turatig/NSS/PresentazionePROS.pdf

# Night Surveillance System: termocamera di

sorveglianza notturna basata su STM32F407.

# Progettazione di Sistemi Operativi

Università degli Studi di Milano.

# July 12, 2022

Giacomo Turati (Università degli Studi di Milano) | Night Surveillance System | July 12, 2022 | 1 / 29

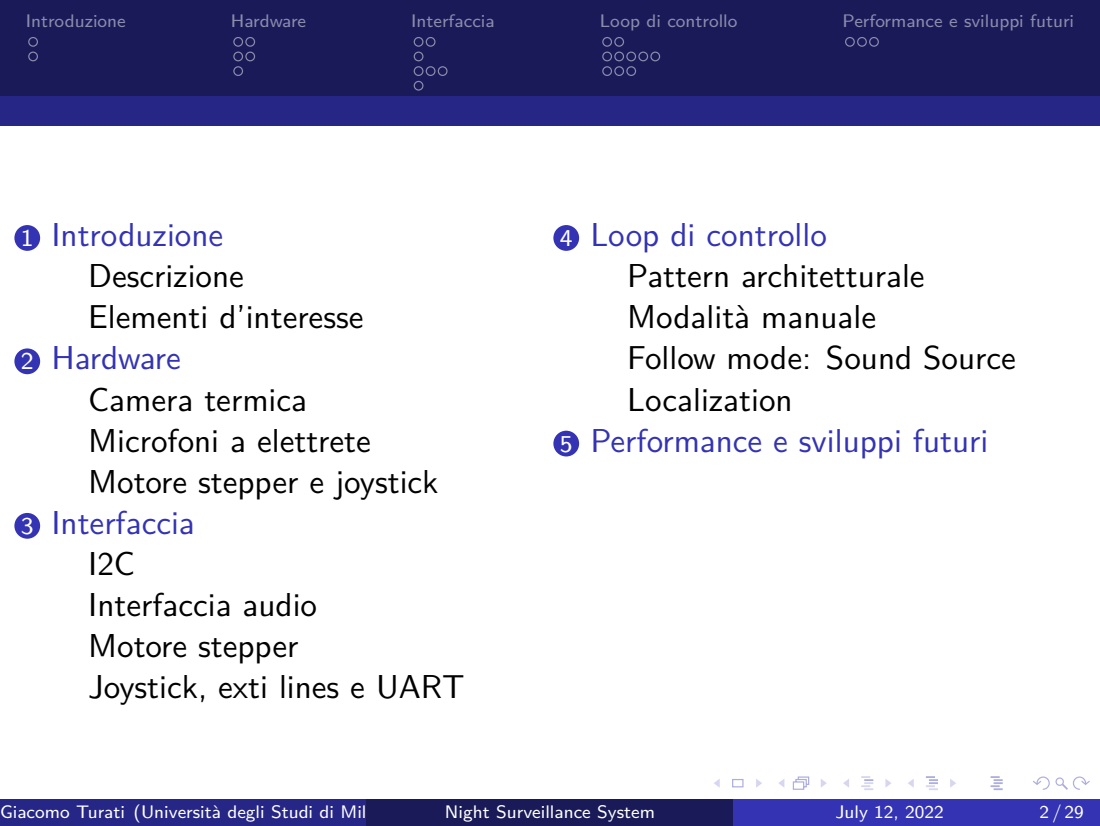
[picture p1: page 2]
Giacomo Turati (Università degli Studi di Milano); Night Surveillance System; July 12, 2022

1 Introduzione
Descrizione
Elementi d’interesse
2 Hardware
Camera termica
Microfoni a elettrete
Motore stepper e joystick
3 Interfaccia
Interfaccia audio
Motore stepper
Joystick, exti lines e UART

4 Loop di controllo
Pattern architetturale
Modalità manuale
Follow mode: Sound Source
Localization
5 Performance e sviluppi futuri

# Il dispositivo si propone come prototipo di camera di sorveglianza notturna con le seguenti modalità di funzionamento:

1 Manuale: consente acquisizione e streaming immagine termica,

# acquisizione e playback audio ambientale in stereo e orientamento

manuale della camera tramite joystick.

# 2 Follow: il dispositivo reagisce a stimoli sonori sopra soglia cercando di

localizzare una sorgente sonora nello spazio circostante.

# Componenti: 1 Camera termica: AMG8833 2 Microfoni a elettrete 3 Motore stepper unipolare 28BYJ-48 4 Joystick analogico 5 Bottoni di controllo 6 STM32F407-discovery1

Giacomo Turati (Università degli Studi di Milano) | Night Surveillance System | July 12, 2022 | 3 / 29

# L’obiettivo del progetto è quello di realizzare un sistema di sorveglianza che monitori diversi tipi di dato ambientali e che possa reagire attivamente

a cambi di circostanze nel perimetro da monitorare.

# Elementi d’interesse a livello di progettazione software: 1 Gestione simultanea di streaming real-time multipli e controllo

attuatori.

# 2 Interazione a basso livello con le componenti hardware e sviluppo di

driver dedicati.

# 3 Scrittura di ISR, utilizzo DMA e periferiche senza mediazione di un

RTOS.

Giacomo Turati (Università degli Studi di Milano) | Night Surveillance System | July 12, 2022 | 4 / 29

# Camera termica

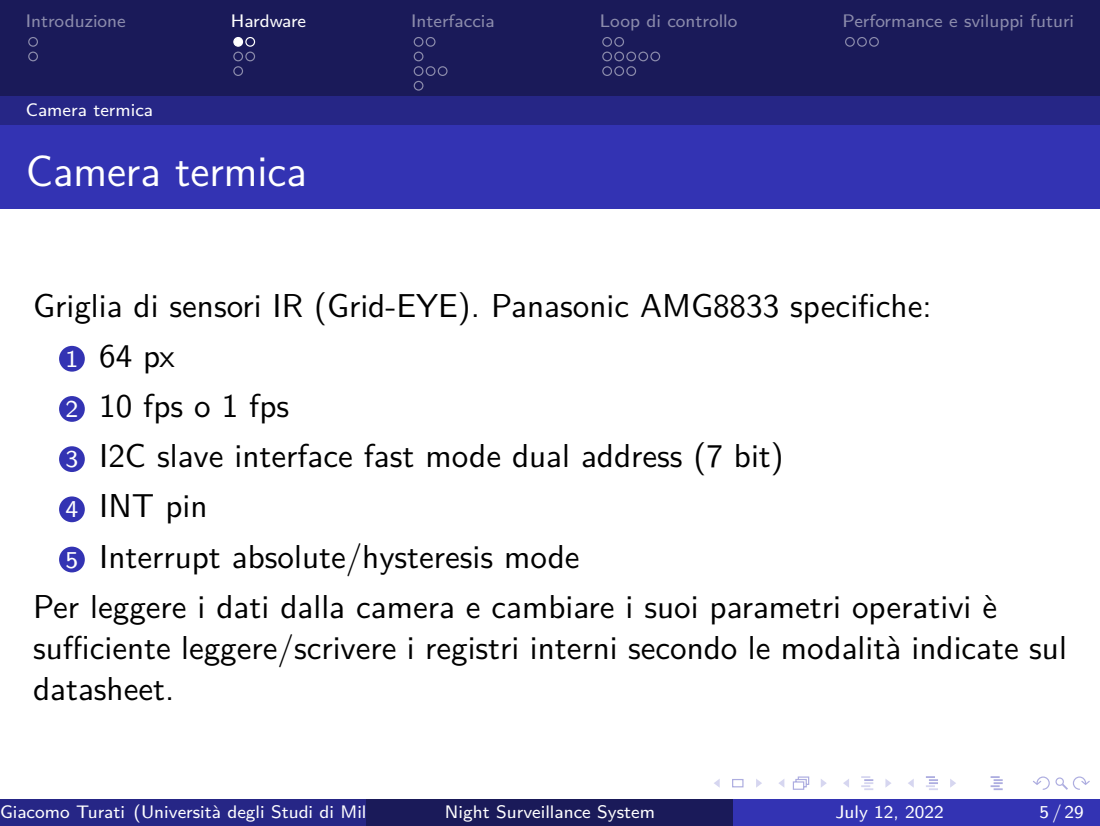
[picture p2: page 5]
Camera termica; Giacomo Turati (Università degli Studi di Milano); Night Surveillance System; July 12, 2022

Griglia di sensori IR (Grid-EYE). Panasonic AMG8833 specifiche:
2 10 fps o 1 fps
3 I2C slave interface fast mode dual address (7 bit)
4 INT pin
5 Interrupt absolute/hysteresis mode
Per leggere i dati dalla camera e cambiare i suoi parametri operativi è
sufficiente leggere/scrivere i registri interni secondo le modalità indicate sul
datasheet.

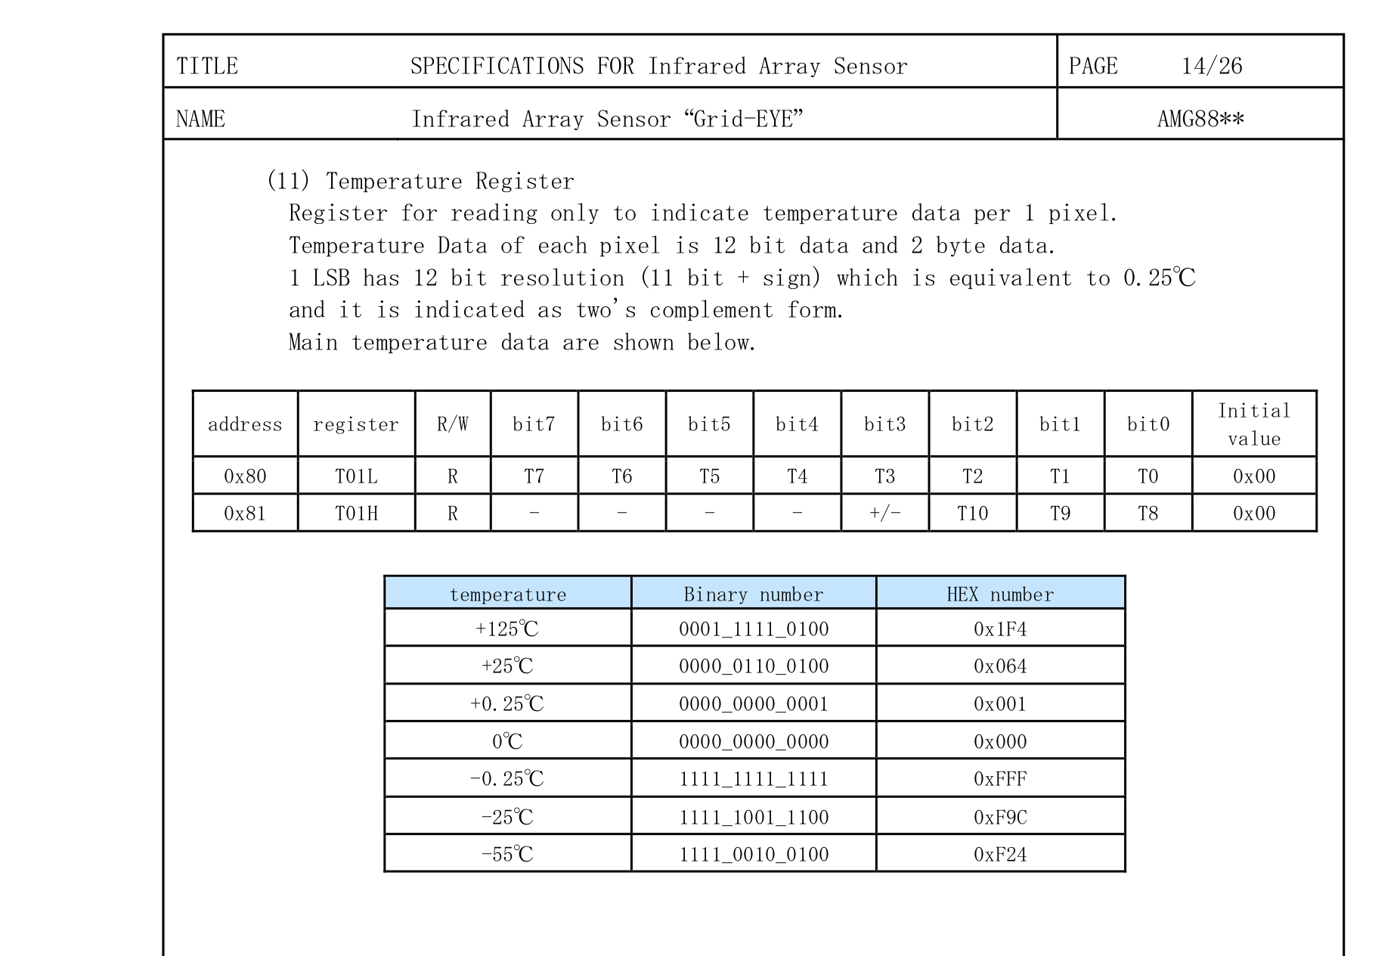
[picture p3: figure]

## Figure 1: Specifiche registri di temperatura datasheet Grid-EYE AMG8833

Giacomo Turati (Università degli Studi di Milano) | Night Surveillance System | July 12, 2022 | 6 / 29

# Microfoni a condensatore basati su membrana di elettrete con carica elettrostatica permanente (no polarizzazione esterna). Alimentazione

necessaria per transistor FET di adattamento in impedenza.

# Specifiche:

1 Range di risposta in frequenza: 20-20kHz.
2 Ampiezza picco-picco 200mV (±100mV) in saturazione.

# Preamplificazione: condizionamento necessario per portare il segnale nel range ADC [0V-3V]. Rail-to-rail opamp (TLE2022) in configurazione

invertente con partitore su terminale positivo.

Giacomo Turati (Università degli Studi di Milano) | Night Surveillance System | July 12, 2022 | 7 / 29

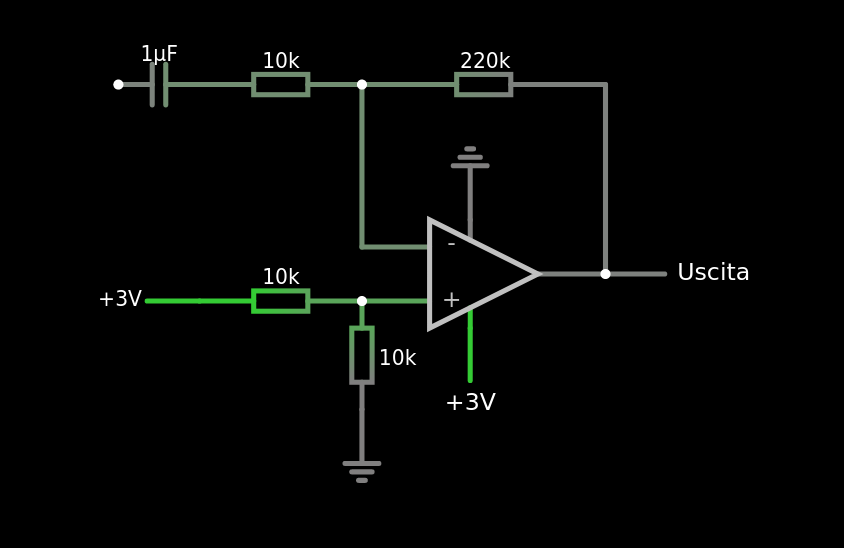
[picture p4: figure]

## Figure 2: Schema circuitale preamplificatore microfonico

Giacomo Turati (Università degli Studi di Milano) | Night Surveillance System | July 12, 2022 | 8 / 29

# Motore stepper e joystick

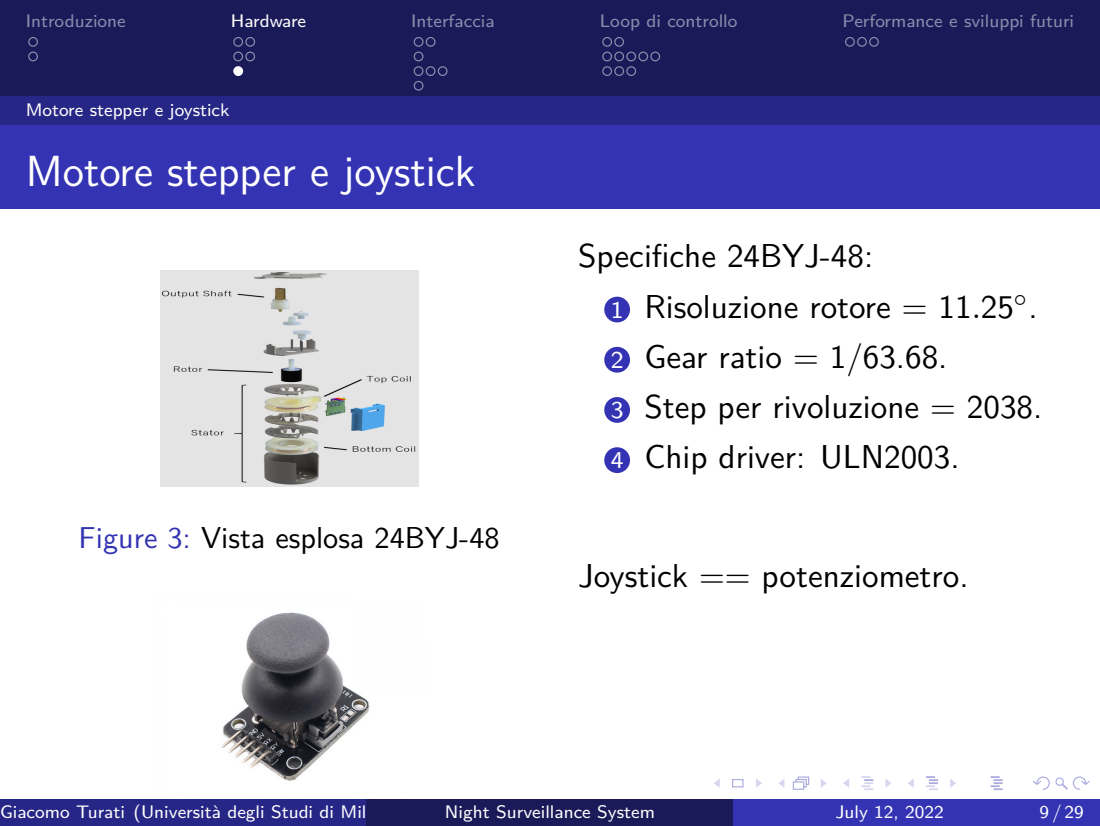
[picture p5: page 9]
Joystick == potenziometro.; Giacomo Turati (Università degli Studi di Milano); Night Surveillance System; July 12, 2022

Motore stepper e joystick

Specifiche 24BYJ-48:
1 Risoluzione rotore = 11.25◦
2 Gear ratio = 1/63.68.
3 Step per rivoluzione = 2038.
4 Chip driver: ULN2003.

Figure 3: Vista esplosa 24BYJ-48

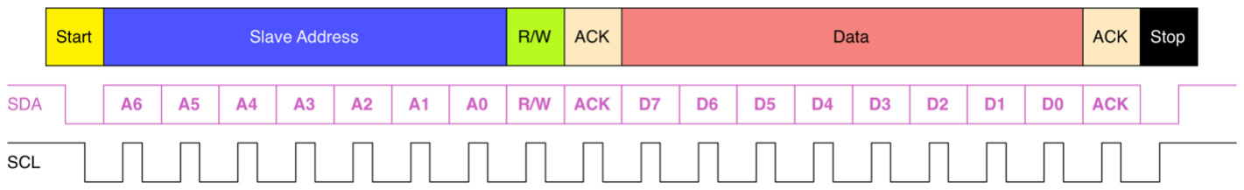
[picture p6: figure]

## Figure 4: Protocollo di comunicazione seriale I2C

# Master inizia le transazioni di lettura/scrittura tramite START condition (HIGH to LOW). Specifica indirizzo dello slave in address frame. Il primo data frame specifica l’indirizzo del registro da cui leggere/in cui scrivere e gli altri sono di dati. Lettura/scrittura con ACK fino a STOP condition

(da LOW ad HIGH).

# Sensore AMG8833 configurato per rispondere a indirizzo a 7 bit 0x68. PB6

e PB7 con resistenze di pull-up esterne per line SCL e SDA a 400kbps.

Giacomo Turati (Università degli Studi di Milano) | Night Surveillance System | July 12, 2022 | 10 / 29

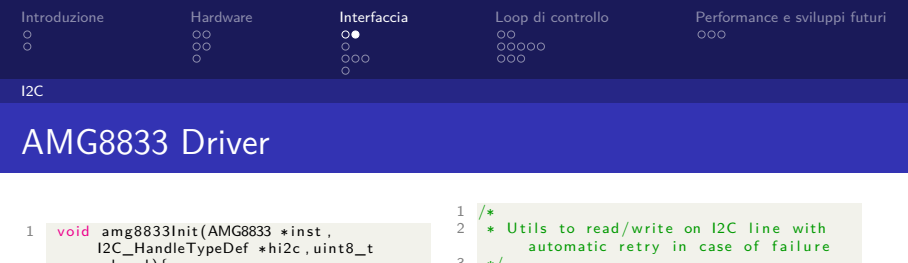
[picture p7: figure]
I2C AMG8833 Driver; I2C_HandleTypeDef ∗hi2c , uint8_t

1 | void amg8833Init (AMG8833 ∗ inst ,
| ad_sel ){
2 | inst −>adri2c= ad_sel ? (
| AMG8833_I2C_BASE_ADR + 1 ) << 1 :
| AMG8833_I2C_BASE_ADR << 1;
3 | inst −>hi2c=hi2c ;
4 | }
1 | /∗
2 | ∗ Read temperature matrix in DMA mode
3 | ∗/
4 | HAL_StatusTypeDef amg8833ReadDMA(AMG8833 ∗
| inst , uint8_t ∗data , uint8_t max_retry
| ){
5
6 | return I2C_ReadDMA( inst ,AMG8833_T01L,
| data ,AMG8833_DS, max_retry ) ;
7 | }
8

2 ∗ U t i l s to read/ write on I2C l i n e with automatic r e t r y in case of f a i l u r e
3 | ∗/
4 | HAL_StatusTypeDef I2C_Read(AMG8833 ∗ inst ,
uint8_t reg , uint8_t ∗data , uint16_t dim , uint8_t max_retry ){
5
6 | uint8_t t r y =0;
7 | HAL_StatusTypeDef status ;
8
9 | do{
10 | t r y++;
| 11 | status=HAL_I2C_Mem_Read_DMA( inst
−>hi2c , ( uint16_t ) inst −>adri2c , reg ,1 ,
| data , dim) ;
12 | } while ( status !=HAL_OK && t r y <=
| max_retry ) ;
| 13
14 | return status ;
| 15
16 | }
| 17
Inoltre scritte funzioni di libreria per la gestione della interrupt mode.
Giacomo Turati (Università degli Studi di Milano) | Night Surveillance System | July 12, 2022 | 11 / 29

# Interfaccia audio

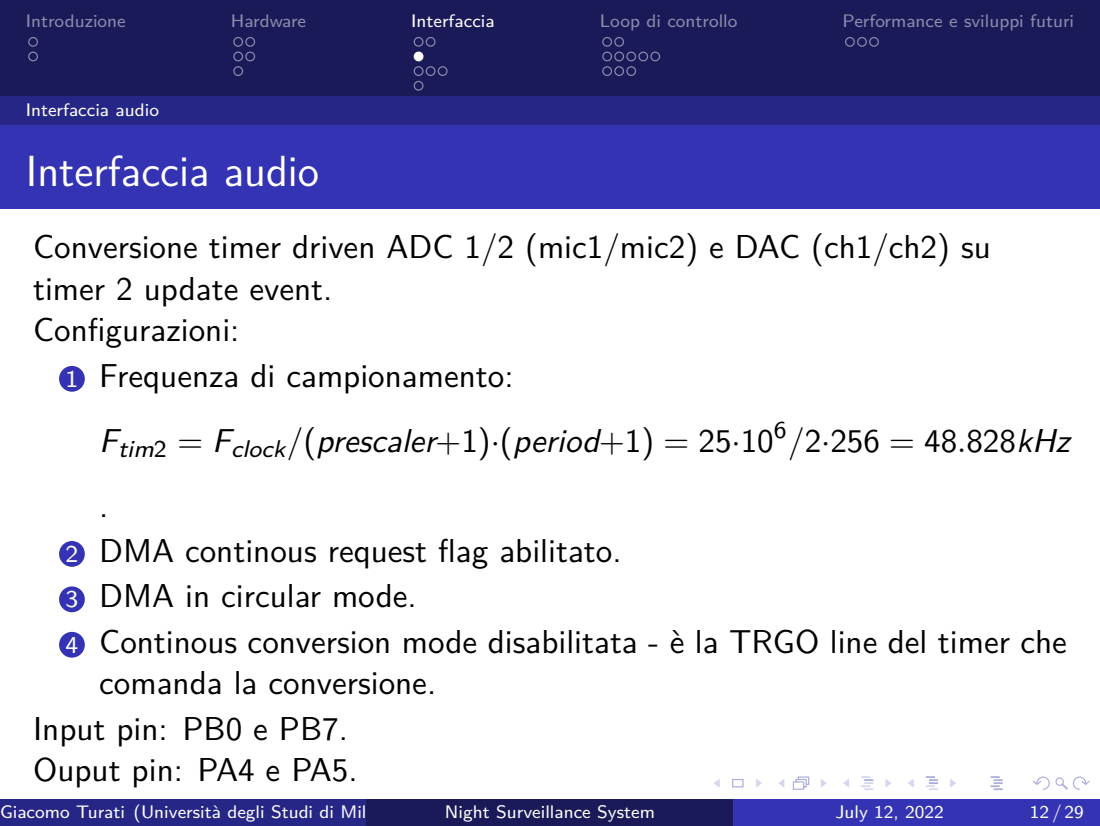
[picture p8: page 12]
Interfaccia audio; /2·256 = 48.828kHz; Giacomo Turati (Università degli Studi di Milano); Night Surveillance System; July 12, 2022

Conversione timer driven ADC 1/2 (mic1/mic2) e DAC (ch1/ch2) su
timer 2 update event.
Configurazioni:
1 Frequenza di campionamento:
Ftim2 = Fclock/(prescaler+1)·(period+1) = 25·10⁶

2 DMA continous request flag abilitato.
3 DMA in circular mode.
4 Continous conversion mode disabilitata - è la TRGO line del timer che
comanda la conversione.
Input pin: PB0 e PB7.
Ouput pin: PA4 e PA5.

# Motore stepper

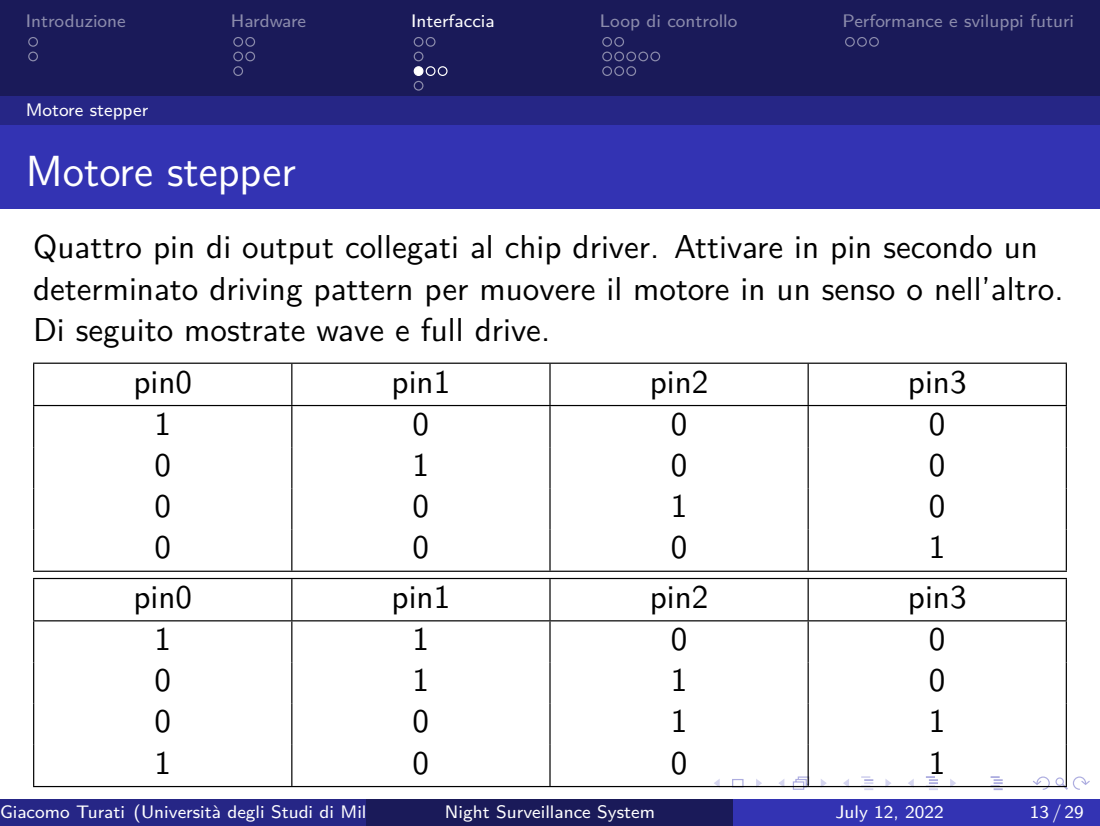
[picture p9: page 13]
Motore stepper; Giacomo Turati (Università degli Studi di Milano); Night Surveillance System; July 12, 2022

Quattro pin di output collegati al chip driver. Attivare in pin secondo un
determinato driving pattern per muovere il motore in un senso o nell’altro.
Di seguito mostrate wave e full drive.

pin0 | pin1 | pin2 | pin3
1 0 0 0 | 0 1 0 0 | 0 0 1 0 | 0 0 0 1

1 0 0 1 | 1 1 0 0 | 0 1 1 0 | 0 0 1 1

# Driver motore

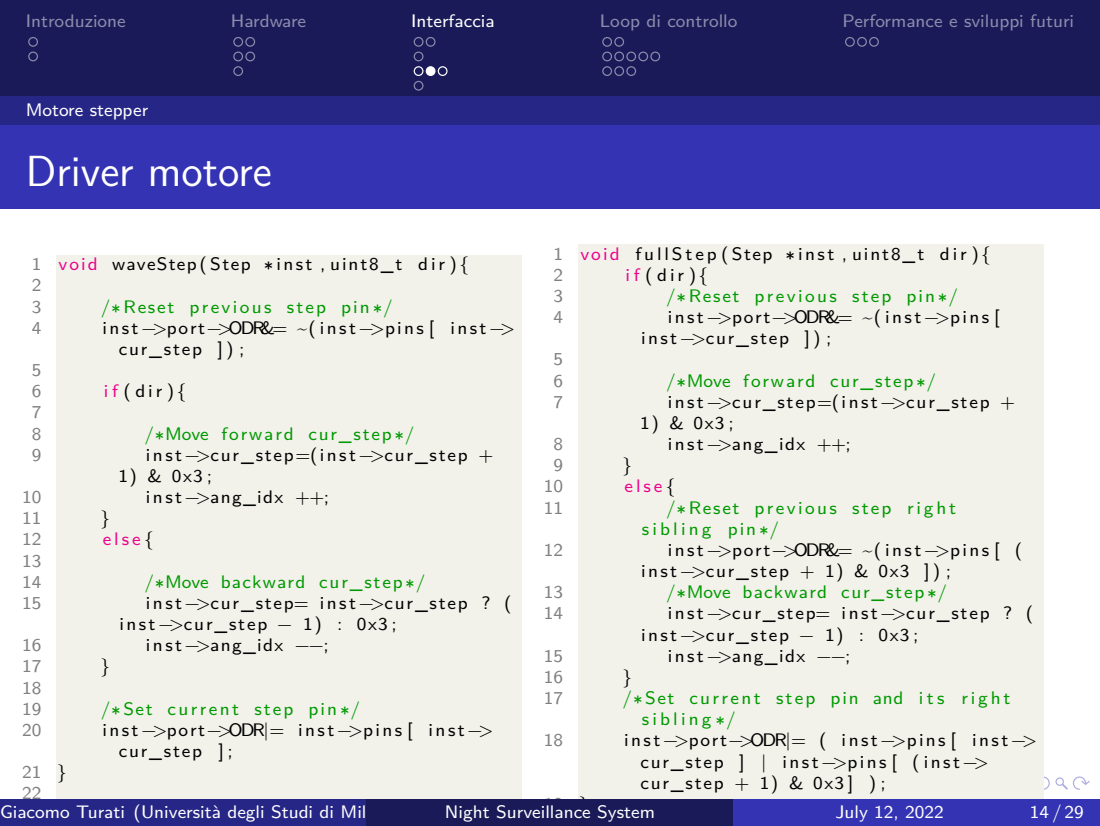
[picture p10: page 14]
Motore stepper; void waveStep ( Step ∗ inst , uint8_t d i r ){; /∗Reset previous step pin ∗/; inst −>port−>ODR&= ~( inst −>pins [ inst −>; cur_step ] ) ;; /∗Move forward cur_step ∗/; inst −>cur_step=(inst −>cur_step +; inst −>ang_idx ++;; /∗Move backward cur_step ∗/; inst −>cur_step= inst −>cur_step ? (; inst −>cur_step − 1) : 0x3 ;; inst −>ang_idx −−;; /∗Set current step pin ∗/; inst −>port−>ODR|= inst −>pins [ inst −>; cur_step ] ;; void f u l l S t e p ( Step ∗ inst , uint8_t d i r ){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

cur_step ] | inst −>pins [ ( inst −>
cur_step + 1) & 0x3 ] ) ;

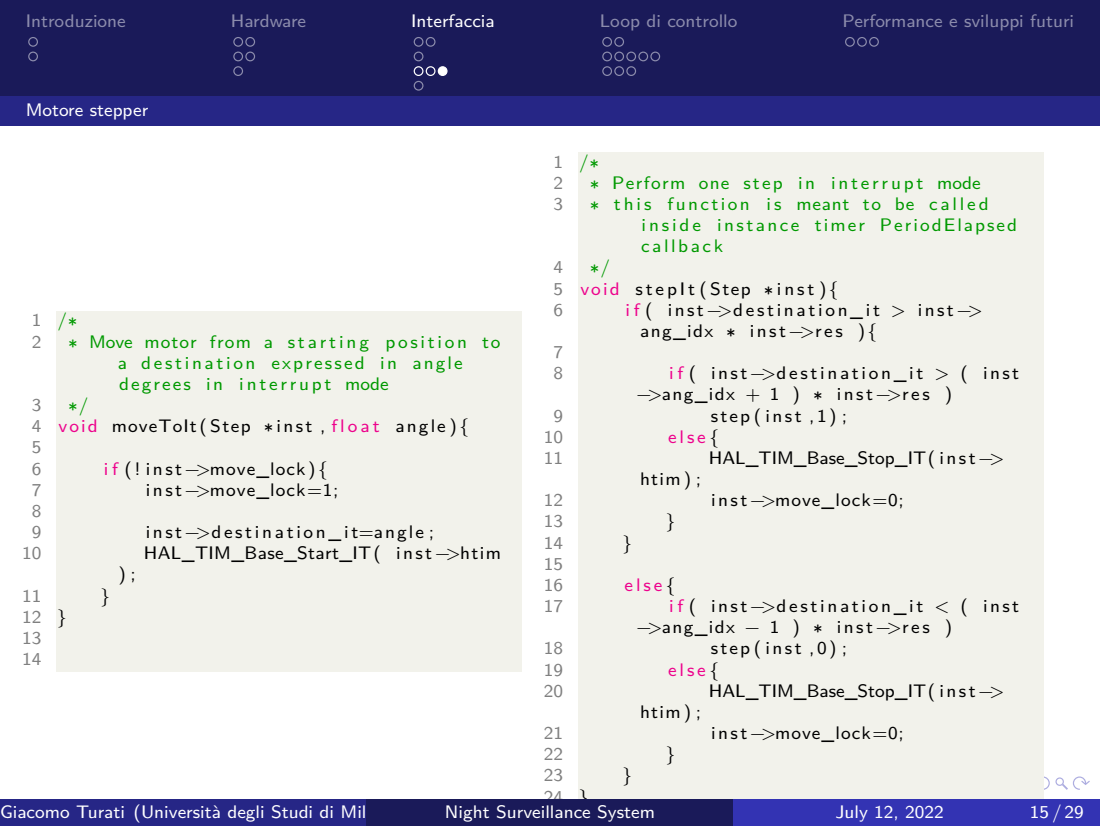
[picture p11: page 15]
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

i n s i d e instance timer PeriodElapsed

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

Giacomo Turati (Università degli Studi di Milano) | Night Surveillance System 25 | 15 / 29

July 12, 2022

# 1 Joystick: alimentato a 3V, conversione in polling mode del valore di

tensione in ingresso all’ADC3. Single channel/conversion mode. Lettura mono-asse, bidirezionale (destra/sinistra).
2 Bottoni di controllo: switch modalità, controllo motore singolo step. Input pin con internal pull-up, external interrupt falling edge mode.

# La pressione di un tasto attiva un timer di debounce allo scadere del

quale lo stato dei pin d’ingresso viene ricontrollato.

# 3 AMG8833 INT pin: external interrupt falling edge mode, resistenza di

pull-up esterna (ingresso open drain).
4 UART3 per output immagine termica e UART6 per print di debug.
Giacomo Turati (Università degli Studi di Milano) | Night Surveillance System | July 12, 2022 | 16 / 29

# Difficoltà principale del progetto: controllo simultaneo di diverse periferiche rispettando le deadline imposte dalla conversione audio, dal frame rate di acquisizione dell’immagine termica e dal movimento fluido

del motore. Impossibile gestire tutte le periferiche in polling sequenziale.

# Obiettivi: architettura uniforme e comprensibile. Codice ISR efficiente e

non-error-prone.

# Soluzione: set/reset di status flag in bit band region nelle ISR e polling

occasionale su questi ultimi nel loop di controllo.

Giacomo Turati (Università degli Studi di Milano) | Night Surveillance System | July 12, 2022 | 17 / 29

# Modalità

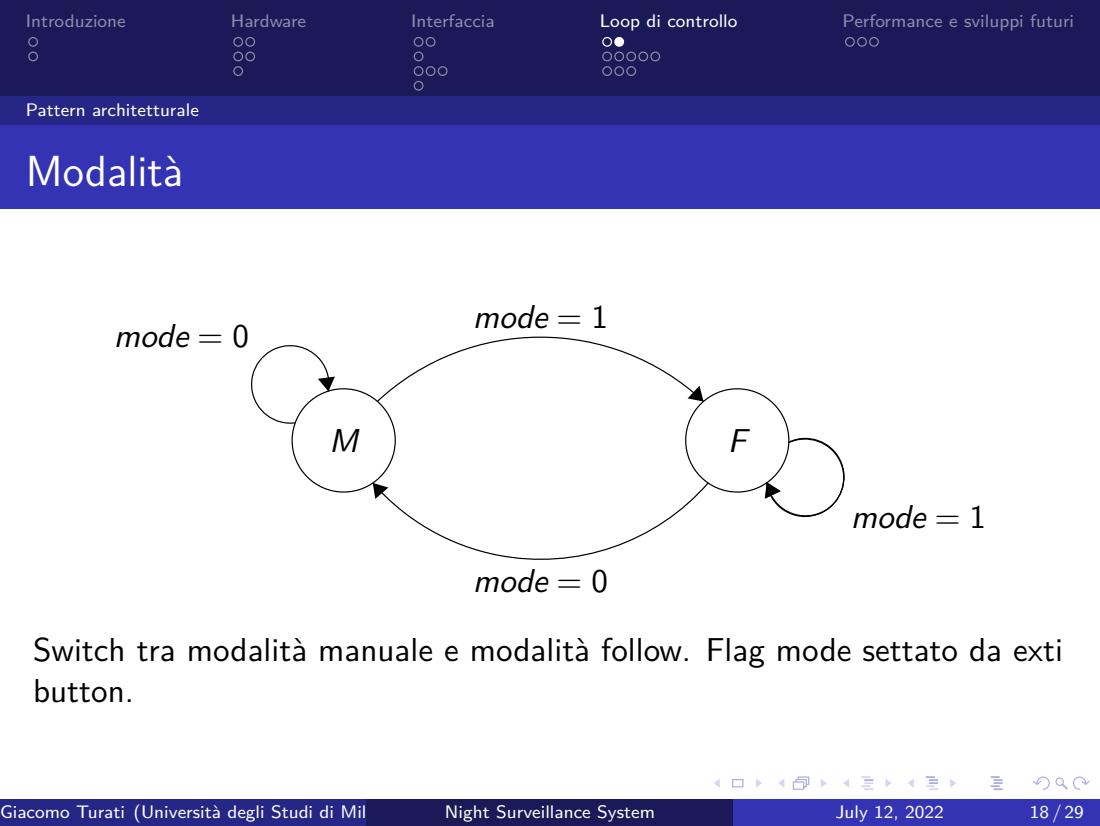
[picture p12: page 18]
Pattern architetturale; mode = 0; mode = 1; Giacomo Turati (Università degli Studi di Milano); Night Surveillance System; July 12, 2022

Switch tra modalità manuale e modalità follow. Flag mode settato da exti
button.

# Thermal image FSM

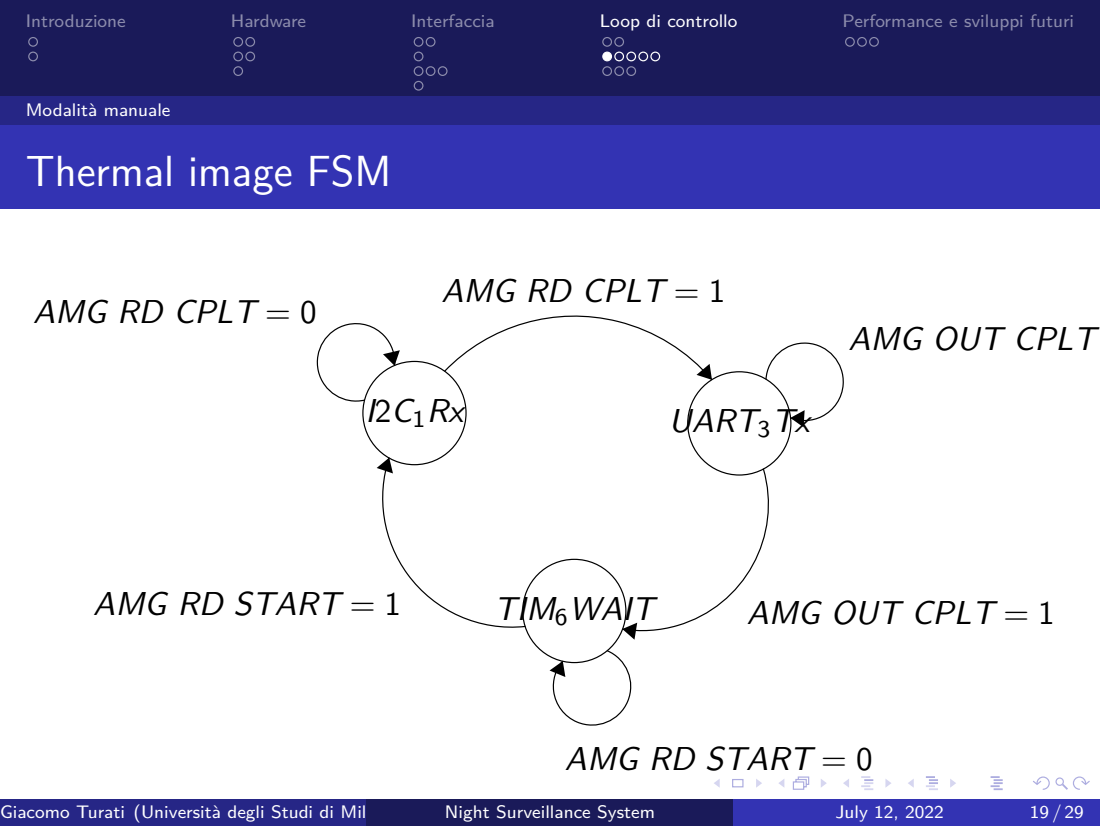
[picture p13: page 19]
Modalità manuale; UART3Tx; TIM6WAIT; Giacomo Turati (Università degli Studi di Milano); Night Surveillance System; July 12, 2022

AMG RD CPLT = 1

AMG RD CPLT = 0

AMG OUT CPLT = 0

AMG RD START = 1

AMG OUT CPLT = 1

AMG RD START = 0

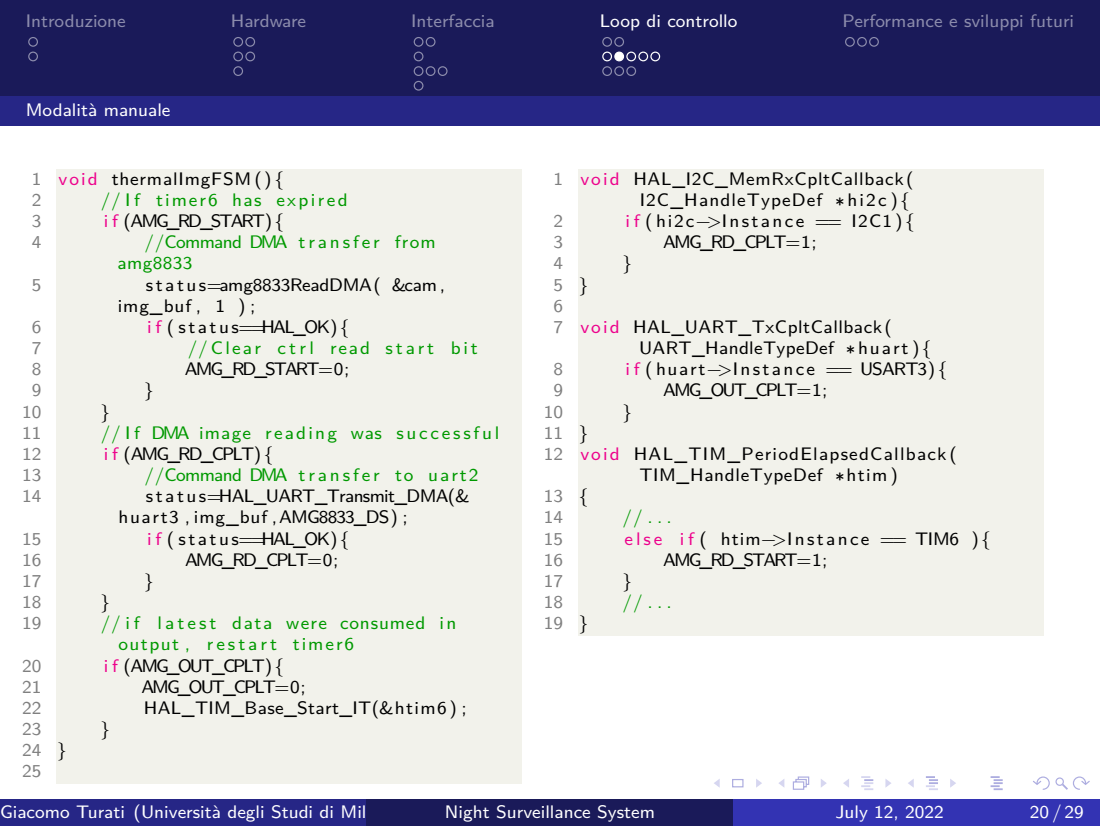
[picture p14: page 20]
Modalità manuale; void thermalImgFSM () {; // I f timer6 has expired; i f (AMG_RD_START){; //Command DMA t r a n s f e r from; amg8833; status=amg8833ReadDMA( &cam ,; img_buf , 1 ) ;; i f ( status==HAL_OK){; //Clear c t r l read s t a r t b i t; AMG_RD_START=0;; // I f DMA image reading was s u c c e s s f u l; i f (AMG_RD_CPLT){; //Command DMA t r a n s f e r to uart2; status=HAL_UART_Transmit_DMA(&; huart3 , img_buf ,AMG8833_DS) ;; AMG_RD_CPLT=0;; // i f l a t e s t data were consumed in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

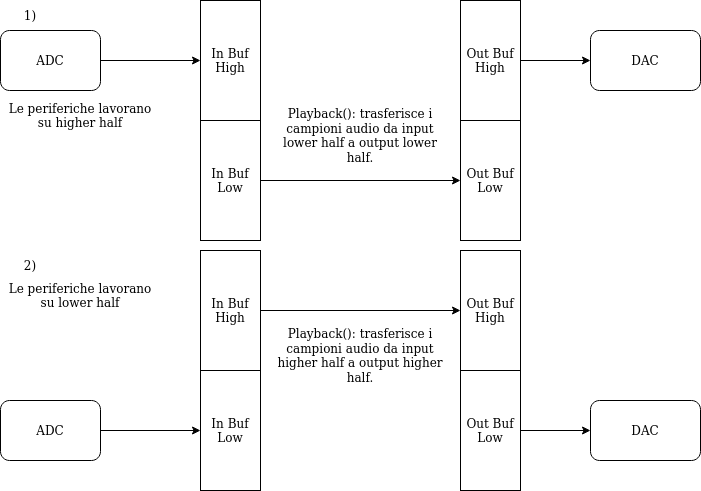
[picture p15: figure]

Taglia totale di buffer = 1024 samples =⇒ half buffer = 512 (0.01sec).

Giacomo Turati (Università degli Studi di Milano) | Night Surveillance System | July 12, 2022 | 21 / 29

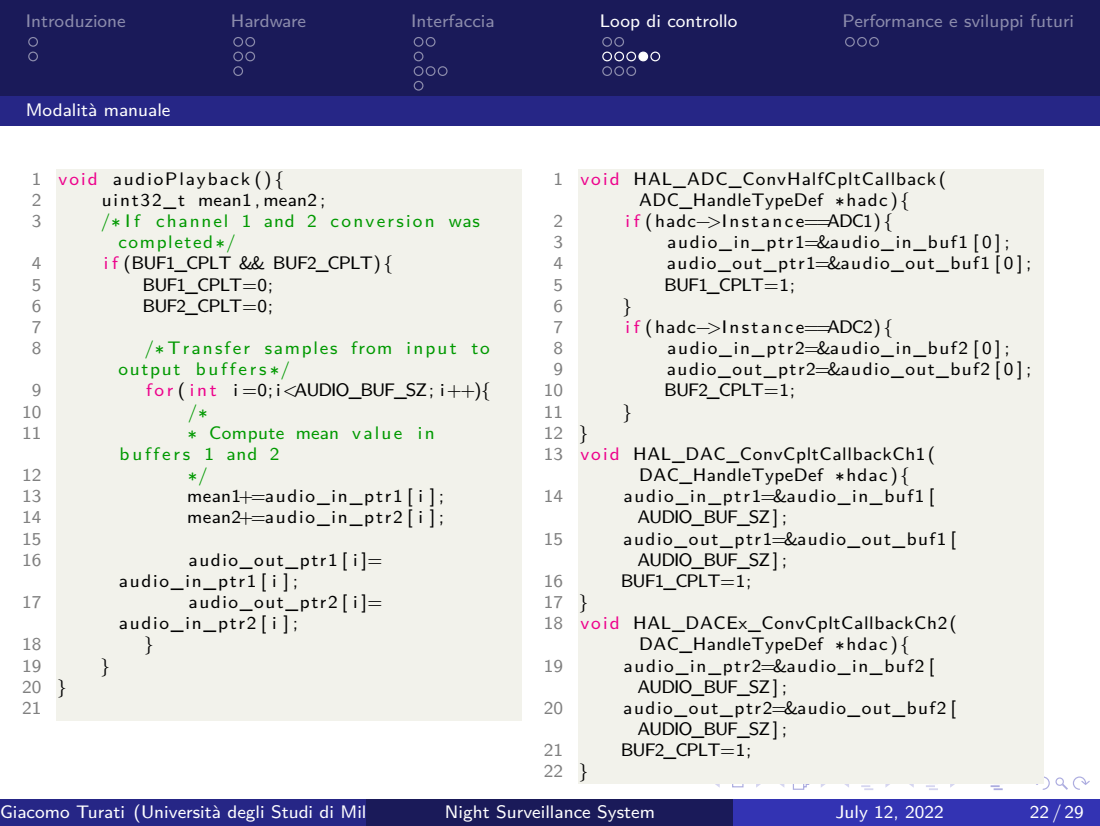
[picture p16: page 22]
Modalità manuale; void audioPlayback () {; uint32_t mean1 , mean2 ;; /∗ I f channel 1 and 2 conversion was; completed∗/; i f (BUF1_CPLT && BUF2_CPLT){; BUF1_CPLT=0;; BUF2_CPLT=0;; /∗ Transfer samples from input to; output b u f f e r s ∗/; f o r ( i n t i =0; i<AUDIO_BUF_SZ; i++){; ∗ Compute mean value in; b u f f e r s 1 and 2; mean1+=audio_in_ptr1 [ i ] ;; mean2+=audio_in_ptr2 [ i ] ;; audio_out_ptr1 [ i ]=; audio_in_ptr1 [ i ] ;; audio_out_ptr2 [ i ]=; audio_in_ptr2 [ i ] ;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

1 | void motorControl () {
2 | J s t i c k D i r d i r ;
3
4 | i f (MOTOR_MV){
5 | MOTOR_MV=0;
6
7 | d i r=j s t i c k G e t D i r P o l l (& j s ) ;
8 | i f ( d i r==LEFT | | LEFT_BUT_PUSH){
9 | LEFT_BUT_PUSH=0;
10 | step(&motor , 1 ) ;
11 | }
12 | e l s e i f ( d i r==RIGHT | | RIGHT_BUT_PUSH){
13 | RIGHT_BUT_PUSH=0;
14 | step(&motor , 0 ) ;
15 | }
16 | }
17
18 }

# Il flag MV è settato dal timer 7 che ogni 2 ms triggera una lettura dei

controlli manuali e il conseguente movimento del motore.

Giacomo Turati (Università degli Studi di Milano) | Night Surveillance System | July 12, 2022 | 23 / 29

# Nella modalità follow (o SSL) il dispositivo reagisce a stimoli sonori nell’ambiente circostante e cerca di identificare il target che ha prodotto il

rumore, per orientare verso di esso la termocamera.

# Pertanto, viene monitorata la potenza RMS di ogni buffer audio in attesa di eventi sopra una soglia preimpostata. Per calcolare RMS è necessario

che il segnale sia a media 0: bisogna rimuovere il DC offset.
Il DC offset, dipendente dalla precisione del circuito di preamplificazione, viene stimato calcolando la media degli ultimi 100 valori medi dei buffer.
Giacomo Turati (Università degli Studi di Milano) | Night Surveillance System | July 12, 2022 | 24 / 29

# Il metodo classico per stimare l’angolo d’incidenza di una sorgente sonora è la cross-correlazione dei segnali. L’operatore permette di calcolare la

Time Difference Of Arrival dello stesso segnale sui due microfoni.

# Probelemi: 1 Fattori di imprecisione nel circuito di condizionamento costruito

ad-hoc per il progetto.
2 Riflessioni ambientali.
L’implementazione è risultata inefficace e molto difficile da debuggare,

# poichè a livello teorico l’algoritmo assume un ambiente privo di riflessioni ed estrema precisione nell’acquisizione (i segnali devono essere identici a

meno di amplificazione e sfasamento).

Giacomo Turati (Università degli Studi di Milano) | Night Surveillance System | July 12, 2022 | 25 / 29

# Per evitare una lunga attività di debug e riprogettazione, si è pensato di implementare una proof-of-concept della modalità follow per mostrare il

processo di automazione sfruttando le feature già implementate.

# Alla rilevazione di almeno due buffer sopra soglia il dispositivo:

1 Abilità la interrupt mode in absolute value sul dispositivo AMG8833.

# 2 Esegue una pan su tutto il campo visivo in interrupt mode, senza

interrompere playback audio e streaming video.

# 3 Il motore viene arrestato quando nell’ottica visuale viene rilevato un oggetto sopra la soglia di temperatura impostata: il sensore genera un

interrupt sul pin INT.

Giacomo Turati (Università degli Studi di Milano) | Night Surveillance System | July 12, 2022 | 26 / 29

# Per verificare il corretto funzionamento è necessario misurare:

1 Frame rate streaming video. Un ciclo completo di I/O ogni 25 ms. Ogni frame è ridondato 4 volte. Pro: sicurezza di non perdere frame, tecnica compatibile con un dispositivo con frame rate maggiore. Contro: maggior dispendio di energia.
2 Conversione audio/ DMA callback. 10 ms.

# 3 Tempo impiegato da loop di playback e preprocess per portare

campioni da input buffer ad ouput buffer e calcolare dc offset e rms. 1 ms.
Tecnica utilizzata: approccio hardware con oscilloscopio.

# Ragioni: disponibilità di strumento e uscita digitale. Rimane l’approccio

che garantisce maggiore precisione.
In entrambe le modalità il dispositivo consuma 20mAh.
Giacomo Turati (Università degli Studi di Milano) | Night Surveillance System | July 12, 2022 | 27 / 29

1 Miglioramento elaborazione dei segnali. 2 Ottimizzazione consumi energetici.
3 Remote control.
Giacomo Turati (Università degli Studi di Milano) | Night Surveillance System | July 12, 2022 | 28 / 29

# DEMO

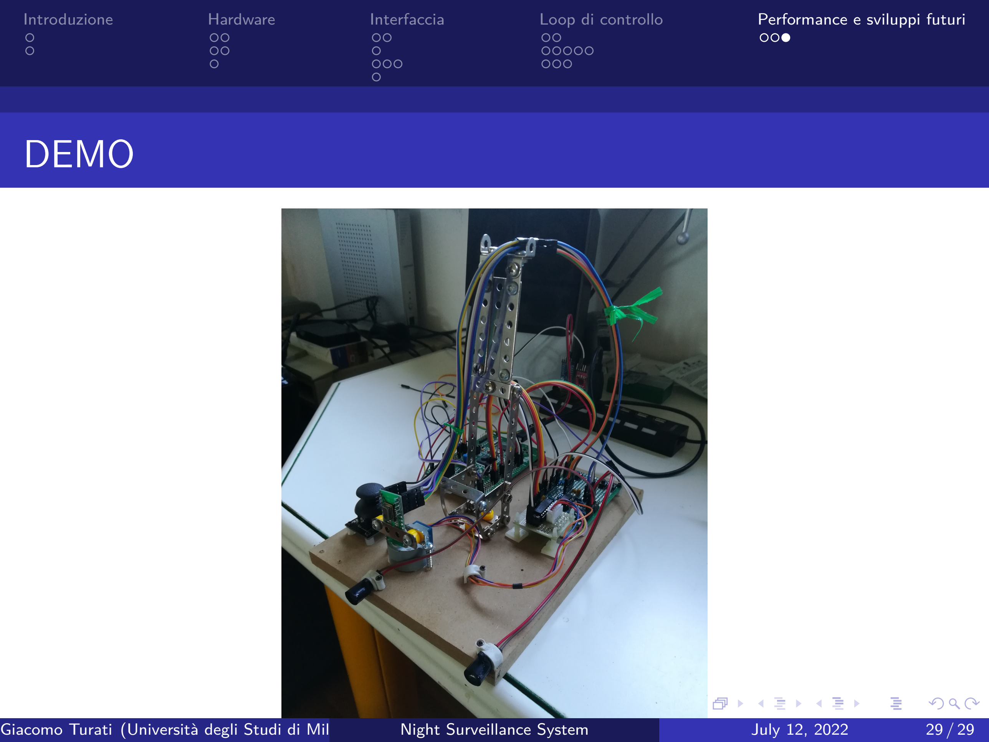
[picture p17: page 29]

Giacomo Turati (Università degli Studi di Milano) | Night Surveillance System | July 12, 2022 | 29 / 29
