turatig/NSS/Core/Src/main.c

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
/* Includes ------------------------------------------------------------------*/
#include "main.h"

/* USER CODE BEGIN Includes */
#include "AMG8833.h"
#include "Step.h"
#include "Jstick.h"
#include <string.h>
#include <stdio.h>
#include <math.h>
/* USER CODE END Includes */

/* USER CODE BEGIN PD */
#define BIT_BAND_ALIAS_REGION_BASE 0x22000000
#define BIT_BAND_ADDR(offset,bit) (BIT_BAND_ALIAS_REGION_BASE + offset*32 + bit*4)

/*Thermal camera FSM (based on amg8833 chip) control byte offset in bit band region*/
#define AMG_CTRL_OSET 0x0
/*Control bits*/
#define AMG_RD_START  (*(volatile uint32_t*)BIT_BAND_ADDR(AMG_CTRL_OSET,0x7))//amg read start flag
#define AMG_RD_CPLT (*(volatile uint32_t*)BIT_BAND_ADDR(AMG_CTRL_OSET,0x6))//amg read complete
#define AMG_OUT_CPLT (*(volatile uint32_t*)BIT_BAND_ADDR(AMG_CTRL_OSET,0x5))//amg output (through uart) complete. Ready for another read
#define AMG_TARGET_DET (*(volatile uint32_t*)BIT_BAND_ADDR(AMG_CTRL_OSET,0x4))//amg interrupt read flag

/*Motor control byte offset in bit band region*/
#define MOTOR_CTRL_OSET 0x1
#define MOTOR_MV (*(volatile uint32_t*)BIT_BAND_ADDR(MOTOR_CTRL_OSET,0x7))

/*Audio control byte offset in bit band region*/
#define AUDIO_CTRL_OSET 0x2
#define BUF1_CPLT (*(volatile uint32_t*)BIT_BAND_ADDR(AUDIO_CTRL_OSET,0x7))
#define BUF2_CPLT (*(volatile uint32_t*)BIT_BAND_ADDR(AUDIO_CTRL_OSET,0x6))

/*Push buttons control byte offset in bit band region*/
#define EXTI_BUT_CTRL_OSET 0x3
#define EXTI_BUT_PUSH (*(volatile uint32_t*)BIT_BAND_ADDR(EXTI_BUT_CTRL_OSET,0x7))

#define MODE_TOGGLE (*(volatile uint32_t*)BIT_BAND_ADDR(EXTI_BUT_CTRL_OSET,0x6))
#define LEFT_BUT_PUSH (*(volatile uint32_t*)BIT_BAND_ADDR(EXTI_BUT_CTRL_OSET,0x5))
#define RIGHT_BUT_PUSH (*(volatile uint32_t*)BIT_BAND_ADDR(EXTI_BUT_CTRL_OSET,0x4))


/*Audio buffer size*/
/*Half of the audio buffer is filled by the main playback and process loop*/
#define AUDIO_BUF_SZ 512
/*Used by the DMA as unit of transfer*/
#define AUDIO_TOT_BUF_SZ (AUDIO_BUF_SZ * 2)

/*Number of last mean values are considered to compute a stable estimate of DC offset*/
#define DC_BUF_SZ 100
/*
 * Number of frame buffers over threshold that trigger sound source localization
 */
#define BUF_OVR_THR 2


/*
 * CROSS-CORRELATION FEATURE CURRENTLY UNUSED
 */
/*Distance between microphones in meters*/
#define MIC_DIST 0.1
/*Sound travel speed expressed in m/s*/
#define V_SOUND 343
/*Sample frequency of audio signal: timer 2 update event frequency*/
#define FS (int)( 25000000 / ( 255 * 2 ))
/*Maximum delay between signals according to the Sound Source Localization model*/
#define MAX_DELAY (int)( FS * MIC_DIST / V_SOUND)
/*
 * Cross-correlation buffer multiplying factor.
 * Tells how many times cross-correlation buffer is bigger than input audio buffer.
 */
#define XCOR_BUF_MULT 3
/*Cross-correlation result array size*/
#define XCOR_BUF_SZ ( AUDIO_BUF_SZ*XCOR_BUF_MULT )

/*
 * Debug macros
 * remove comments to debug single components
 */
//#define DAC_DEBUG 1
//#define DEBUG_LOG 1
/*
 * Time measurements macros
 * If one of this is set, PE11 pin output can be read with the oscilloscope to
 */
//#define TIME_PREPROC 1
//#define TIME_CONV_CH1 1
//#define TIME_CONV_CH2 1
//#deinfe TIME_XCOR 1
//#define TIME_VIDEO_STREAM 1
//#define TIME_AUDIO_STREAM 1
/*
* Set oscilloscope timer trigger
*/
#define CHRONO_START() GPIOE->ODR|=GPIO_PIN_11
/*
* Reset oscilloscope timer trigger
*/
#define CHRONO_STOP() GPIOE->ODR&=~GPIO_PIN_11



/* USER CODE END PD */

 ADC_HandleTypeDef hadc1;
ADC_HandleTypeDef hadc2;
ADC_HandleTypeDef hadc3;
DMA_HandleTypeDef hdma_adc1;
DMA_HandleTypeDef hdma_adc2;

DAC_HandleTypeDef hdac;
DMA_HandleTypeDef hdma_dac1;
DMA_HandleTypeDef hdma_dac2;

I2C_HandleTypeDef hi2c1;
DMA_HandleTypeDef hdma_i2c1_rx;

TIM_HandleTypeDef htim2;
TIM_HandleTypeDef htim4;
TIM_HandleTypeDef htim6;
TIM_HandleTypeDef htim7;
TIM_HandleTypeDef htim10;

UART_HandleTypeDef huart3;
UART_HandleTypeDef huart6;
DMA_HandleTypeDef hdma_usart3_tx;
DMA_HandleTypeDef hdma_usart6_tx;

/* USER CODE BEGIN PV */
/* Driver data structure to abstract sensors and their interactions*/

AMG8833 cam;
Step motor;
Jstick js;

char msg_buf[128];
HAL_StatusTypeDef status;

/*Thermal image buffer*/
uint8_t img_buf[AMG8833_DS];

/*
 * Audio input and output ping-pong buffers
 */
uint16_t audio_in_buf1[AUDIO_TOT_BUF_SZ];
uint16_t audio_out_buf1[AUDIO_TOT_BUF_SZ];

uint16_t audio_in_buf2[AUDIO_TOT_BUF_SZ];
uint16_t audio_out_buf2[AUDIO_TOT_BUF_SZ];


/*
 * Audio buffer pointers switched by the ISR relative to DMA transfer
 */
volatile uint16_t *audio_in_ptr1;
volatile uint16_t *audio_out_ptr1;

volatile uint16_t *audio_in_ptr2;
volatile uint16_t *audio_out_ptr2;

/*
 * DC offset buffer to compute a stable estimate of DC offset of the two channels.
 * DC offset must be removed in order to have a zero mean signals to compute RMS etc...
 * This buffer will store the last DC_OSET_BUF_SZ mean values computed on input buffers channel 1-2
 */
uint16_t dc_buf_ch1[DC_BUF_SZ];
uint16_t dc_buf_ch2[DC_BUF_SZ];
uint16_t dc_buf_idx;

/*
 * Every time RMS of both input buffers happen to be above the threshold this counter is incremented(max 3).
 * Else will be reset to 0
 */
uint8_t ovr_thr_cnt;

/*
 * RMS above this threshold to trigger SSL event
 */
uint16_t threshold;
/*Mode bit set by the main loop*/
uint8_t mode;


/* CROSS-CORRELATION FEATURE CURRENTLY UNUSED
 * Cross-correlation buffers.
 * These buffers will contain audio samples without DC offset
 */

int xcor_buf1[ XCOR_BUF_SZ ];
int xcor_buf2[ XCOR_BUF_SZ ];
char xcor_res_str[1024];
/*
 * Cross-correlation buffer offset.
 * This counter is incremented xcor_buf_oset=( xcor_buf_idx+1 ) % XCOR_BUF_MULT.
 * Remind that XCOR_BUF_SZ = AUDIO_BUF_SZ * XCOR_BUF_MULT
 */
uint8_t xcor_buf_oset;

/* USER CODE END PV */

void SystemClock_Config(void);
static void MX_GPIO_Init(void);
static void MX_TIM6_Init(void);
static void MX_DMA_Init(void);
static void MX_I2C1_Init(void);
static void MX_ADC3_Init(void);
static void MX_ADC1_Init(void);
static void MX_DAC_Init(void);
static void MX_TIM2_Init(void);
static void MX_ADC2_Init(void);
static void MX_USART3_UART_Init(void);
static void MX_TIM7_Init(void);
static void MX_USART6_UART_Init(void);
static void MX_TIM10_Init(void);
static void MX_TIM4_Init(void);
/* USER CODE BEGIN 0 */

#ifdef DAC_DEBUG
	uint16_t square_wv[AUDIO_TOT_BUF_SZ];

	//Test DAC channels reproducing a square wave
	void testDAC(){
		for(int i=0; i<AUDIO_TOT_BUF_SZ; i++){
			if(i>AUDIO_BUF_SZ)
				square_wv[i]=0;
			else
				square_wv[i]=2048;
		}
		HAL_TIM_Base_Start_IT(&htim2);
		HAL_DAC_Start_DMA(&hdac,DAC_CHANNEL_1,(uint32_t*)square_wv,AUDIO_TOT_BUF_SZ,DAC_ALIGN_12B_R);
		HAL_DAC_Start_DMA(&hdac,DAC_CHANNEL_2,(uint32_t*)square_wv,AUDIO_TOT_BUF_SZ,DAC_ALIGN_12B_R);
		while(1){
			__NOP();
		}
	}
#endif


/*
 * Handler for thermal image DMA memory transfer cplt interrupt
 * Thermal image reading is now complete
 */
void HAL_I2C_MemRxCpltCallback(I2C_HandleTypeDef *hi2c){
	if(hi2c->Instance == I2C1){
		AMG_RD_CPLT=1;
	}
}

/*
 * Handler for thermal image DMA memory transfer cplt interrupt
 * Thermal image output is now complete
 */
void HAL_UART_TxCpltCallback(UART_HandleTypeDef *huart){
	if(huart->Instance == USART3){
		AMG_OUT_CPLT=1;
	}
}



/* Thermal image Finite State Machine
 * Based on bits set by ISR associated with thermal image I/O events.
 * Image flows from AMG sensor to UART interface
 * Timer 6 ISR
 * 		AMG_OUT_CPLT ==> AMG_RD_START
 * DMA1 Stream 0 (Thermal image I2C Rx) Rx Cplt ISR
 * 		AMG_RD_START ==> AMG_RD_CPLT
 * DMA1 Stream 6 (Thermal image USART2 Tx) Tx Cplt ISR
 * 		AMG_RD_CPLT ==> AMG_OUT_CPLT
 *
 */
void thermalImgFSM(){
	  /*
	   * Thermal camera FSM
	   */
	  //If timer6 has expired
	  if(AMG_RD_START){

		  //Command DMA transfer from amg8833
		status=amg8833ReadDMA( &cam,img_buf, 1 );
		if(status==HAL_OK){
			//Clear ctrl read start bit
			AMG_RD_START=0;
#ifdef TIME_VIDEO_STREAM
			CHRONO_START();
#endif
		}
	  }

	  //If DMA image reading was successful
	  if(AMG_RD_CPLT){
		 //Command DMA transfer to uart2
		 status=HAL_UART_Transmit_DMA(&huart3,img_buf,AMG8833_DS);
		 if(status==HAL_OK){
			 AMG_RD_CPLT=0;
		 }
	  }
	  //if latest data were consumed in output, restart timer6
	  if(AMG_OUT_CPLT){
		  AMG_OUT_CPLT=0;
		  HAL_TIM_Base_Start_IT(&htim6);

#ifdef TIME_VIDEO_STREAM
			CHRONO_STOP();
#endif
	  }
}



/*
 * Handler for audio input DMA memory transfer half-cplt interrupt
 * AUDIO_BUF_SZ sample were converted and put into audio_in_buf.
 * Data can be moved by main application from lower audio_in_buf to higher audio_out_buf
 */

void HAL_ADC_ConvHalfCpltCallback(ADC_HandleTypeDef *hadc){
	if(hadc->Instance==ADC1){

#ifdef TIME_CONV_CH1
		CHRONO_START();
#endif
		audio_in_ptr1=&audio_in_buf1[0];
		audio_out_ptr1=&audio_out_buf1[0];
		BUF1_CPLT=1;
	}

	if(hadc->Instance==ADC2){

#ifdef TIME_CONV_CH2
		CHRONO_START();
#endif
		audio_in_ptr2=&audio_in_buf2[0];
		audio_out_ptr2=&audio_out_buf2[0];
		BUF2_CPLT=1;
	}
}

/*
 * Handler for audio input DMA memory transfer half-cplt interrupt
 * AUDIO_TOT_BUF_SZ sample were taken from audio out buf and fed into DAC.
 * Data can be moved by main application from higher audio_in_buf to lower audio_out_buf
 */
void HAL_DAC_ConvCpltCallbackCh1(DAC_HandleTypeDef *hdac){

#ifdef TIME_CONV_CH1
	CHRONO_STOP();
#endif
	audio_in_ptr1=&audio_in_buf1[AUDIO_BUF_SZ];
	audio_out_ptr1=&audio_out_buf1[AUDIO_BUF_SZ];
	BUF1_CPLT=1;
}

void HAL_DACEx_ConvCpltCallbackCh2(DAC_HandleTypeDef *hdac){

#ifdef TIME_CONV_CH2
	CHRONO_STOP();
#endif
	audio_in_ptr2=&audio_in_buf2[AUDIO_BUF_SZ];
	audio_out_ptr2=&audio_out_buf2[AUDIO_BUF_SZ];
	BUF2_CPLT=1;
}


/*
 * Audio playback process.
 * Transfer audio samples from input buffer to output buffer using pointers set by ISR (ping-pong buffers).
 * Used by main application during calibration mode
 */

void audioPlayback(){

	uint32_t mean1,mean2;

	/*If channel 1 and 2 conversion was completed*/
	if(BUF1_CPLT && BUF2_CPLT){
		BUF1_CPLT=0;
		BUF2_CPLT=0;

#ifdef TIME_AUDIO_STREAM
			CHRONO_START();
#endif

		/*Transfer samples from input to output buffers*/
		for(int i=0;i<AUDIO_BUF_SZ;i++){
			/*
			 * Compute mean value in buffers 1 and 2
			 */
			mean1+=audio_in_ptr1[i];
			mean2+=audio_in_ptr2[i];

			audio_out_ptr1[i]=audio_in_ptr1[i];
			audio_out_ptr2[i]=audio_in_ptr2[i];

		}
		/*
		 * Enqueue last mean value computed and increment DC buffer pointer
		 */
		dc_buf_ch1[dc_buf_idx]=(uint16_t)( mean1/AUDIO_BUF_SZ );
		dc_buf_ch2[dc_buf_idx]=(uint16_t)( mean2/AUDIO_BUF_SZ );

		dc_buf_idx=( dc_buf_idx + 1 ) % DC_BUF_SZ;

#ifdef TIME_AUDIO_STREAM
			CHRONO_STOP();
#endif
	}

}

/*
 * Audio preprocessing.
 * Transfer audio samples from input buffer to output buffer using pointers set by ISR (ping-pong buffers).
 * DC offset is removed from every sample and threshold overflow is computed.
 * Used by main application during SSL mode
 */
void audioPreproc(){
	uint32_t mean1,mean2;
	uint32_t dc1,dc2;
	float rms1,rms2;

	/*
	 * Preproc loop will set rms values of last buf1 and buf2 to trigger cross-correlation
	 */

	/*If channel 1 and 2 conversion was completed*/
	if(BUF1_CPLT && BUF2_CPLT){

#ifdef 	TIME_PREPROC
		CHRONO_START();
#endif
		BUF1_CPLT=0;
		BUF2_CPLT=0;

		mean1=0;
		mean2=0;

		dc1=0;
		dc2=0;

		rms1=0;
		rms2=0;
		

		/*
		 * Transfer samples from input to cross-correlation buffers
		 */
		for( int i=0 ; i<AUDIO_BUF_SZ || i<DC_BUF_SZ ; i++ ){

			/*
			 * Compute the mean value of input buffers 1 and 2
			 */
			if(i<AUDIO_BUF_SZ){
				mean1+=audio_in_ptr1[i];
				mean2+=audio_in_ptr2[i];

				/*
				 * Fill the DAC buffer
				 */
				audio_out_ptr1[i]=audio_in_ptr1[i];
				audio_out_ptr2[i]=audio_in_ptr2[i];
			}
			/*
			 * Compute estimate of DC offset based on the last DC_BUF_SZ mean values computed in buffers
			 */
			if(i<DC_BUF_SZ){
				dc1+=dc_buf_ch1[dc_buf_idx];
				dc2+=dc_buf_ch2[dc_buf_idx];
			}

		}

		/*
		 * Enqueue current mean value of input buffer in dc buffer
		 */
		dc_buf_ch1[dc_buf_idx]=(uint16_t)( mean1/AUDIO_BUF_SZ );
		dc_buf_ch2[dc_buf_idx]=(uint16_t)( mean2/AUDIO_BUF_SZ );

		dc1/=DC_BUF_SZ;
		dc2/=DC_BUF_SZ;

		/*
		 * Subtract DC offset to have 0 mean signal in cross-correlation buffer.
		 * Compute RMS of signals in ch1-2 input buffers
		 */

		for(int i=0,idx;i<AUDIO_BUF_SZ;i++){

			idx=xcor_buf_oset * AUDIO_BUF_SZ + i;
			/*
			 * CROSS-CORRELATION FEATURE CURRENTLY UNUSED
			 */
			xcor_buf1[idx]=audio_in_ptr1[i] - dc1;
			xcor_buf2[idx]=audio_in_ptr2[i] - dc2;

			rms1+=( xcor_buf1[idx] * xcor_buf1[idx] ) / AUDIO_BUF_SZ;
			rms2+=( xcor_buf2[idx] * xcor_buf2[idx] ) / AUDIO_BUF_SZ;

		}

		rms1=sqrt(rms1);
		rms2=sqrt(rms2);

#ifdef TIME_PREPROC
		CHRONO_STOP();
#endif
		
		/*
		 * If any of the input buffers has RMS under threshold
		 */
		if(rms1>threshold && rms2>threshold){

#ifdef DEBUG_LOG
			sprintf(msg_buf,"\r\nrms1:%d\r\nrms2:%d\r\nthreshold:%dratio:%f\r\n"
					,(int)rms1,(int)rms2,threshold, (float)rms1/(float)rms2 );
			HAL_UART_Transmit(&huart6,(uint8_t*)msg_buf,strlen(msg_buf),20);
#endif

			/*Increment over threshold counter up to 3*/
			if(ovr_thr_cnt<BUF_OVR_THR)
				ovr_thr_cnt++;
		}
		else{
			ovr_thr_cnt=0;
		}


		/*
		 * Update cross-correlation circular buffer offset
		 * XCOR_BUF_SZ = AUDIO_BUF_SZ * XCOR_BUF_MULT
		 */
		xcor_buf_oset=( xcor_buf_oset + 1 ) % XCOR_BUF_MULT;

		/*
		 * Update DC buffer offset idx
		 */
		dc_buf_idx=( dc_buf_idx + 1 ) % DC_BUF_SZ;

	}
}

/*
 * Callback function to manage external interrupt push buttons pushed
 */
void HAL_GPIO_EXTI_Callback(uint16_t GPIO_PIN){
	/*
	 * Manage interrupt on exti line from AMG8833 sensor
	 */
	if( GPIO_PIN == GPIO_PIN_15 ){

		AMG_TARGET_DET=1;
		stop( &motor );
	}
	/*
	 * Other exti lines interrupts come from push buttons: GPIO_PIN_2/3/4
	 */
	else if( !EXTI_BUT_PUSH  ){
		EXTI_BUT_PUSH=1;
		//Start debounce timer: interrupt after 50 ms
		HAL_TIM_Base_Start_IT(&htim10);
	}
}

/*
 * Manage audio/video streaming while searching a target towards a destination
 * expressed in angle degree
 */
void searchWhilePlay(float angle){
	 /*
	  * Move to the right limit
	  */
	 moveToIt( &motor,angle );

	 /*
	  * While motor is in motion
	  */
	 while( motor.move_lock ){

		 audioPreproc();
		 thermalImgFSM();
	 }

}
void targetDetect(){
	  /*
	   * Set absolute value value threshold to detect hot objects
	   * Test it with this threshold by making noise and light on a lighter
	   * Adjust threshold to 28° detect a human in a room at approximately 20°
	   */
	  amg8833SetAbsHighThrs( &cam,(uint16_t)( 37.0/0.25 ),2 );
	  /*
	   * Set absolute threshold interrupt mode
	   */
	  amg8833SetIntMode( &cam,1,2 );
	  /*
	   * Enable interrupt on amg8833
	   */
	  amg8833IntEn( &cam,3 );
	  /*
	   * Reset interrupt flag
	   */
	  AMG_TARGET_DET=0;

	 /*
	  * Pan with the camera and stop the movement if amg8833 triggers interrupt on exti line (i.e. target detected)
	  */
	 if( motor.ang_idx > 0 ){
		 /*
		  * Move to the right limit and stop if target is detected
		  */
		 searchWhilePlay( -80.0 );
		 /*
		  * If no target was detected
		  */
		 if(!AMG_TARGET_DET){
			 /*
			  * Move to the left limit and stop if target is detected
			  */
			 searchWhilePlay( 80.0 );
		 }
	 }
	 else{
		 searchWhilePlay( 80.0 );

		 if(!AMG_TARGET_DET){
			 searchWhilePlay( -80.0 );
		 }
	 }
	 /*
	  * Disable amg8833 interrupt
	  */
	 amg8833IntDis( &cam,2 );

	 if( AMG_TARGET_DET ){

		 sprintf( msg_buf,"Target was detected at angle: %f\r\n", motor.ang_idx*motor.res );
		 HAL_UART_Transmit( &huart6,(uint8_t *)msg_buf,strlen(msg_buf),HAL_MAX_DELAY);
	 }

	 AMG_TARGET_DET=0;

}


/* CROSS-CORRELATION FEATURE CURRENTLY UNUSED
 * Cross correlation function.
 * In order to avoid biased values at borders cross correlation buffer size is XCOR_BUF_MULT*AUDIO_BUF_SZ
 */
void xcor(){


#ifdef TIME_XCOR
	CHRONO_START();
#endif

	/*
	 * Compute index of the center i.e. segment of size AUDIO_BUF_SZ cross correlated between buf1 and buf2.
	 */
	uint8_t center_oset=xcor_buf_oset > 0 ? xcor_buf_oset-1 : 2;
	//uint8_t center_oset=xcor_buf_oset;
	//uint8_t shifted_oset_buf2=center_oset_buf1 > 0 ? center_oset_buf1-1 : 2;

	int buf1_idx=center_oset * AUDIO_BUF_SZ;
	int buf2_idx;

	float max=-1.0;
	int max_idx=0;
	//normalization factor
	float abs1,abs2;
	float mean1,mean2;
	float r;

	char str[32];
	xcor_res_str[0]='\0';

	for(int i=-MAX_DELAY;i<=MAX_DELAY;i++){

		mean1=0;
		mean2=0;

		r=0;
		abs1=0;
		abs2=0;
		/*
		 * Shift buf1 centered mask on buf2
		 */
		if( buf1_idx + i >= 0 ){
			buf2_idx = ( buf1_idx + i ) % XCOR_BUF_SZ;
		}
		else{
			/*
			 * As long as buf1_idx + i < 0 occurs only when i is < 0 and buf1_idx is 0
			 */
			buf2_idx = XCOR_BUF_SZ + i;
		}

		for(int j=0; j<AUDIO_BUF_SZ;j++){
			mean1+=xcor_buf1[ buf1_idx + j  ];
			mean2+=xcor_buf2[ ( buf2_idx + j ) % XCOR_BUF_SZ ];
		}

		mean1/=AUDIO_BUF_SZ;
		mean2/=AUDIO_BUF_SZ;


		for(int j=0;j<AUDIO_BUF_SZ;j++){
			/*
			 * Accumulate products and normalize to avoid
			 */
			abs1+=( xcor_buf1[ buf1_idx + j ] - mean1 ) * ( xcor_buf1[ buf1_idx + j ] - mean1 );
			abs2+=( xcor_buf2[ ( buf2_idx + j ) % XCOR_BUF_SZ ] - mean2 ) * ( xcor_buf2[ ( buf2_idx + j ) % XCOR_BUF_SZ ] - mean2 );
			r+=( xcor_buf1[ buf1_idx + j ] - mean1 ) * ( xcor_buf2[ ( buf2_idx + j ) % XCOR_BUF_SZ ] - mean2 );
		}

		if( abs1<0 || abs2<0)
			GPIOD->ODR|=GPIO_PIN_13;

		r/=sqrt( abs1 * abs2 );


		if( r > max){
			max=r;
			max_idx=i;
		}

#ifdef DEBUG_LOG
		sprintf(str,"%f ",r);
		strcat(xcor_res_str,str);
		sprintf(msg_buf,"\r\n\r\nmean1:%f\r\nmean2:%f\r\nmax_del:%d\r\ni:%d\r\nxor_buf: %d\r\nbuf1_idx:%d\r\nbuf2_idx:%d\r\nval:%f\r\n",mean1,mean2,MAX_DELAY,i,XCOR_BUF_SZ,buf1_idx,buf2_idx,r);
		HAL_UART_Transmit(&huart6,(uint8_t *)msg_buf,strlen(msg_buf),HAL_MAX_DELAY);
#endif
	}

#ifdef DEBUG_LOG
	sprintf(msg_buf,"Delay which maximizes cross-correlation:%d\r\nval:%f\r\ncnt:%d\r\n",max_idx,max,ovr_thr_cnt);
	HAL_UART_Transmit(&huart6,(uint8_t *)msg_buf,strlen(msg_buf),HAL_MAX_DELAY);
	HAL_UART_Transmit(&huart6,(uint8_t *)xcor_res_str,strlen( xcor_res_str ),HAL_MAX_DELAY);
#endif

#ifdef TIME_XCOR
	CHRONO_STOP();
#endif
}


/*
 * Log debug UART interface motor position computed since the latest call to rstAngle(&motor)
 */
void logMotor(){

	sprintf(msg_buf,"Motor position: %f\r\nStep angular resolution: %f\r\nAngular index:%d \r\n\r\n\r\n",
								motor.ang_idx*motor.res,motor.res,motor.ang_idx);
	HAL_UART_Transmit_DMA(&huart6,(uint8_t*)msg_buf,strlen(msg_buf));
}

/*
 * Read joystick's position and EXTI buttons and perform one motor step according to joystick direction
 */
void motorControl(){

	JstickDir dir;

	if(MOTOR_MV){
		MOTOR_MV=0;

		dir=jstickGetDirPoll(&js);
		if(dir==LEFT || LEFT_BUT_PUSH){
			LEFT_BUT_PUSH=0;
			step(&motor,1);

#ifdef DEBUG_LOG
			logMotor();
#endif

		}
		else if(dir==RIGHT || RIGHT_BUT_PUSH){
			RIGHT_BUT_PUSH=0;
			step(&motor,0);

#ifdef DEBUG_LOG
			logMotor();
#endif
		}
	}

}

/*Functions to init calibration/sound source localization mode*/
void initCalibration(){
	GPIOD->ODR&=~GPIO_PIN_15;
}

/*
 * Initi Sound Source Localization mode
 */
void initSSL(){

	  /*Reset motor angle idx to 0 to set initial camera offset*/
	  rstAngle(&motor);
	  logMotor();
	  mode=1;

	  /*Reset xcor_buf_oset*/
	  xcor_buf_oset=0;

	  /*Reset threshold to a start value of 100*/
	  threshold=50;
	  /*Reset over threshold counter*/
	  ovr_thr_cnt=0;

	  sprintf(msg_buf,"Max delay between audio signals (in samples):%d\r\b",MAX_DELAY);
	  HAL_UART_Transmit(&huart6,(uint8_t*)msg_buf,strlen(msg_buf),HAL_MAX_DELAY);
	  /*Toggle led to notify the mode change*/
	  GPIOD->ODR|=GPIO_PIN_15;
}
/* USER CODE END 0 */

/**
  * @brief  The application entry point.
  * @retval int
  */
int main(void)
{
  /* MCU Configuration--------------------------------------------------------*/

  /* Reset of all peripherals, Initializes the Flash interface and the Systick. */
  HAL_Init();

  /* Configure the system clock */
  SystemClock_Config();

  /* USER CODE BEGIN SysInit */
  HAL_I2C_DeInit(&hi2c1);
  /* USER CODE END SysInit */

  /* Initialize all configured peripherals */
  MX_GPIO_Init();
  MX_TIM6_Init();
  MX_DMA_Init();
  MX_I2C1_Init();
  MX_ADC3_Init();
  MX_ADC1_Init();
  MX_DAC_Init();
  MX_TIM2_Init();
  MX_ADC2_Init();
  MX_USART3_UART_Init();
  MX_TIM7_Init();
  MX_USART6_UART_Init();
  MX_TIM10_Init();
  MX_TIM4_Init();
  /* USER CODE BEGIN 2 */


#ifdef DAC_DEBUG
  testDAC();
#endif


  /*
   * Init DMA handle data structures for thermal image in/out transfer
   */
  HAL_DMA_Init(&hdma_i2c1_rx);
  HAL_DMA_Init(&hdma_usart3_tx);

  HAL_Delay(50);

  /*Init amg8833 sensor with ad select pin connected to the ground*/
  amg8833Init(&cam,&hi2c1,0);

  /*Wait until amg8833 is ready*/
  while(!amg8833IsReady( &cam, 5 )){
	  GPIOD->ODR|=GPIO_PIN_14;
	  HAL_Delay(20);
  }

  GPIOD->ODR&=~GPIO_PIN_14;

  /*
   * Reset camera to initial condition
   */
  amg8833Reset(&cam, 3);

  HAL_Delay(50);

  /*Start Timer 6 - Update event every 0.025 s for thermal camera reading*/
  HAL_TIM_Base_Start_IT(&htim6);
  /*Start Timer 7 - Update event every 1/10 s for motor control*/
  HAL_TIM_Base_Start_IT(&htim7);

  uint16_t dc_init=2048;
  /*
   * Fill dc offset estimation with intial value
   */
  for(int i=0;i<DC_BUF_SZ;i++){
	  dc_buf_ch1[i]=dc_init;
	  dc_buf_ch2[i]=dc_init;
  }
  /*
   * Start audio clock
   */
  HAL_TIM_Base_Start_IT(&htim2);
  /*
   * Start audio DMA continous reading
   * ADC1 and DAC both works with htim2 conversion clock
   */
  HAL_ADC_Start_DMA(&hadc1,(uint32_t*)audio_in_buf1,AUDIO_TOT_BUF_SZ);
  HAL_ADC_Start_DMA(&hadc2,(uint32_t*)audio_in_buf2,AUDIO_TOT_BUF_SZ);

  /*Start DMA request to playback audio through DAC channels 1 and 2*/
  HAL_DAC_Start_DMA(&hdac,DAC_CHANNEL_1,(uint32_t*)audio_out_buf1,AUDIO_TOT_BUF_SZ,DAC_ALIGN_12B_R);
  HAL_DAC_Start_DMA(&hdac,DAC_CHANNEL_2,(uint32_t*)audio_out_buf2,AUDIO_TOT_BUF_SZ,DAC_ALIGN_12B_R);

  /*Init step motor data structure*/
  initStep(&motor,GPIO_PIN_1,GPIO_PIN_2,GPIO_PIN_3,GPIO_PIN_4,GPIOD,FULL,&htim4);

  /*Init joystick img_buf structure with yellow error pin*/
  initJstick(&js,&hadc3,GPIO_PIN_12,GPIOD);
  /*Start ADC3 associated with joystick*/
  HAL_ADC_Start(&hadc3);

  /* USER CODE END 2 */

  /* Infinite loop */
  /* USER CODE BEGIN WHILE */
  MODE_TOGGLE=0;
  mode=1;
  threshold=100;

  while (1)
  {
	  thermalImgFSM();

	  /*MODE_TOGGLE bit is set by the EXTI4 button line debounce timer TIM10*/
	  if( !MODE_TOGGLE ){
		  /*
		   * Calibration mode:
		   * -microphones AD conversion can be tested connecting an oscilloscope or an amplifier to DAC channels 1/2
		   * -camera can be moved manually using joystick and buttons to set angular offset
		   */
		  if(mode){
			  initCalibration();
			  mode=0;
		  }

		  audioPlayback();
		  motorControl();
	  }
	  else{
		  if(!mode){
			  /*
			   * Sound Source Localization mode
			   */
			  initSSL();
			  mode=1;
			  HAL_Delay( 100 );
		  }
		  /*
		   * Preprocess audio and compute RMS of audio buffers
		   */
		  audioPreproc();
		  /*
		   * If more than BUF_OVR_THR consecutive buffers were found to be over the threshold
		   * trigger hot target detection
		   */
		 if( ovr_thr_cnt >= BUF_OVR_THR ){
			 targetDetect();
		 }

	  }
    /* USER CODE END WHILE */

    /* USER CODE BEGIN 3 */
  }
  /* USER CODE END 3 */
}

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
/**
  * @brief  Period elapsed callback in non blocking mode
  * @note   This function is called  when TIM1 interrupt took place, inside
  * HAL_TIM_IRQHandler(). It makes a direct call to HAL_IncTick() to increment
  * a global variable "uwTick" used as application time base.
  * @param  htim : TIM handle
  * @retval None
  */
void HAL_TIM_PeriodElapsedCallback(TIM_HandleTypeDef *htim)
{
  if (htim->Instance == TIM1) {
    HAL_IncTick();
  }
  /* USER CODE BEGIN Callback 1 */
  /*
   * Step api callback: perform one step while moving to an angle in interrupt mode
   */
  else if( htim->Instance == TIM4 ){
	  stepIt(&motor);
  }
  /*
   * Time to start another I2C read of temperature matrix of AMG8833 sensor
   */
  else if( htim->Instance == TIM6 ){
	  AMG_RD_START=1;
  }
  /*
   * Read joystick and move motor in manual mode
   */
  else if( htim->Instance == TIM7 ){
	MOTOR_MV=1;
  }

  /*
   * Push buttons debounce timer started by exti line interrupt ( possible button pressure)
   */
  else if( htim->Instance == TIM10 ){

	  /*
	   * Check which button results still pressed time elapsed and set appropriate flag.
	   */
	  if( GPIOE->IDR & GPIO_PIN_2 && EXTI_BUT_PUSH  )
		  LEFT_BUT_PUSH=1;

	  else if( GPIOE->IDR & GPIO_PIN_3  && EXTI_BUT_PUSH )
		  RIGHT_BUT_PUSH=1;

	  else if( GPIOE->IDR & GPIO_PIN_4 && EXTI_BUT_PUSH )
		  /*
		   * Toggle main mode
		   */
		  MODE_TOGGLE^=1;

	  EXTI_BUT_PUSH=0;

  }

  /* USER CODE END Callback 1 */
}

/**
  * @brief  This function is executed in case of error occurrence.
  * @retval None
  */
void Error_Handler(void)
{
  /* USER CODE BEGIN Error_Handler_Debug */
  /* User can add his own implementation to report the HAL error return state */
  __disable_irq();
  while (1)
  {
  }
  /* USER CODE END Error_Handler_Debug */
}

#ifdef  USE_FULL_ASSERT
/**
  * @brief  Reports the name of the source file and the source line number
  *         where the assert_param error has occurred.
  * @param  file: pointer to the source file name
  * @param  line: assert_param error line source number
  * @retval None
  */
void assert_failed(uint8_t *file, uint32_t line)
{
  /* USER CODE BEGIN 6 */
  /* User can add his own implementation to report the file name and line number,
     ex: printf("Wrong parameters value: file %s on line %d\r\n", file, line) */
  /* USER CODE END 6 */
}
#endif /* USE_FULL_ASSERT */
