turatig/NSS/thermal_camera.ioc

Mcu.UserName=STM32F407VGTx
PA1.Signal=ADCx_IN1
PA4.Signal=COMP_DAC1_group
PA5.Signal=COMP_DAC2_group
PA7.Signal=ADCx_IN7
PB0.Signal=ADCx_IN8
PB10.Signal=USART3_TX
PB11.Signal=USART3_RX
PB6.Signal=I2C1_SCL
PB7.Signal=I2C1_SDA
PC15-OSC32_OUT.Signal=GPXTI15
PC6.Signal=USART6_TX
PC7.Signal=USART6_RX
PD1.Signal=GPIO_Output
PD12.Signal=GPIO_Output
PD13.Signal=GPIO_Output
PD14.Signal=GPIO_Output
PD15.Signal=GPIO_Output
PD2.Signal=GPIO_Output
PD3.Signal=GPIO_Output
PD4.Signal=GPIO_Output
PE11.Signal=GPIO_Output
PE2.Signal=GPXTI2
PE3.Signal=GPXTI3
PE4.Signal=GPXTI4
