turatig/NSS/Core/Inc/Jstick.h

/*
 * Jstick.h
 *
 *  Created on: Mar 28, 2022
 *      Author: jack
 */

#ifndef INC_JSTICK_H_
#define INC_JSTICK_H_

#include "stm32f4xx.h"

/*Mono directional joystick data structure*/
typedef struct{
	ADC_HandleTypeDef *hadc;
	uint16_t errpin;
	GPIO_TypeDef *errport;
}Jstick;

typedef enum{
	CENTER=0x0,
	LEFT=0x1,
	RIGHT=0x2
}JstickDir;

/*
 * hadc in single conversion - single channel mode
 * GPIO port and pin number of a led to notify error in joystick position reading
 */
void initJstick(Jstick *inst,ADC_HandleTypeDef *hadc,uint16_t errpin,GPIO_TypeDef *errport);
JstickDir jstickGetDirPoll(Jstick *inst);

#endif /* INC_JSTICK_H_ */
