turatig/NSS/(commit log)

2022-03-12 AMG8833 sensor driver module started: AMG8833IsReady + AMG8833ReadPoll feature implemented
2022-03-29 Motor and joystick polling drivers + AMG8833 DMA mode started
2022-04-01 AMG8833 sensor DMA mode completed + Thermal image FSM + Joystick refactor
2022-04-20 Second microphone conversion + playback + step motor refactor
2022-04-28 Motor control and lib refactor + audio refactor (ADC dual mode definitely dropped)
2022-05-05 Motor features step (wave and full) with angular awareness + exti buttons + definitive main architecture (calibration and ssl mode) + debug terminal added
2022-05-06 Stepper motor interrupt mode movement added
2022-07-26 Last commit little amed: frequency of timer 6 corrected in report and comments
    [main.c]
