turatig/NSS/(notices)

Notices in the files:
Core/Src/main.c:
© Copyright (c) 2022 STMicroelectronics.
All rights reserved.
This software component is licensed by ST under Ultimate Liberty license
